SmartDev527/Temp_Con_CHB702/Photo/Screenshot 2025-01-17 143652.png

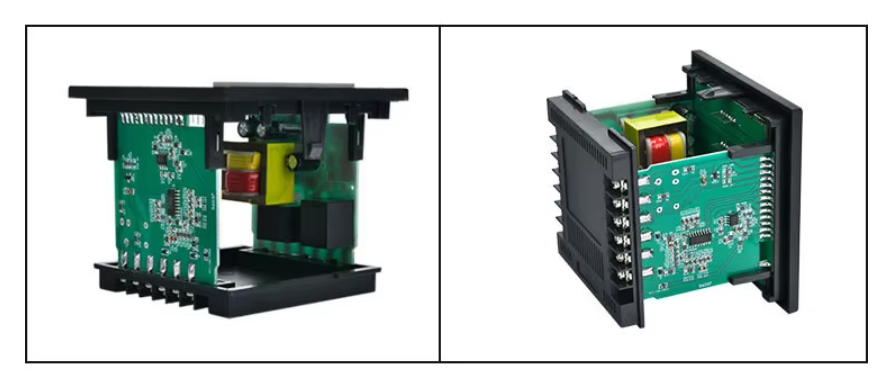
Photo/Screenshot 2025-01-17 143652.png
