SmartDev527/Temp_Con_CHB702/datasheets/7seg_multiplexing.png

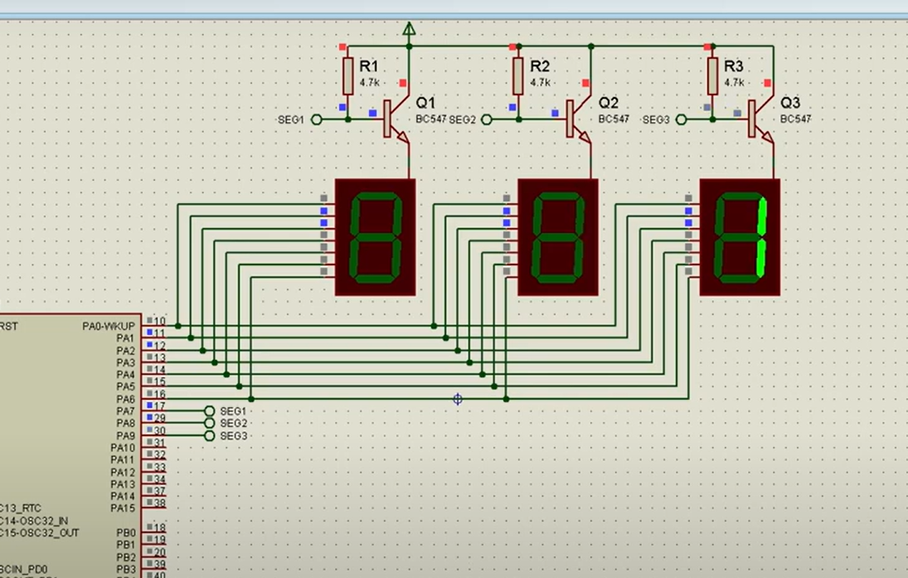
datasheets/7seg_multiplexing.png
