SmartDev527/Temp_Con_CHB702/datasheets/220VAC-12VDC.png

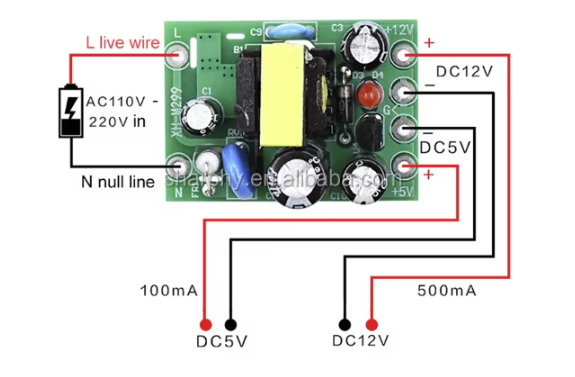
datasheets/220VAC-12VDC.png
