SmartDev527/Temp_Con_CHB702/datasheets/Application.png

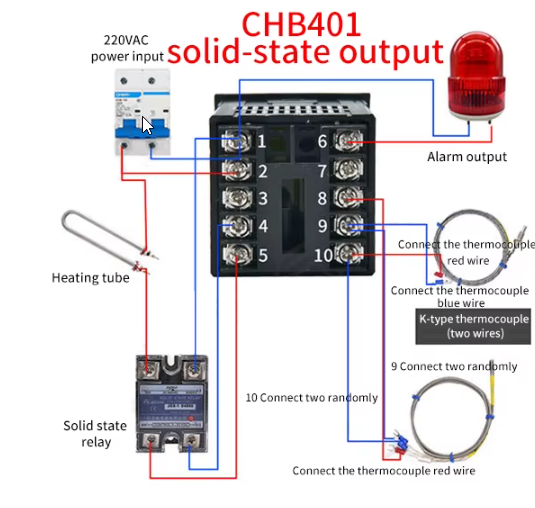
datasheets/Application.png
