SmartDev527/Temp_Con_CHB702/datasheets/JLPCB_Quote.png

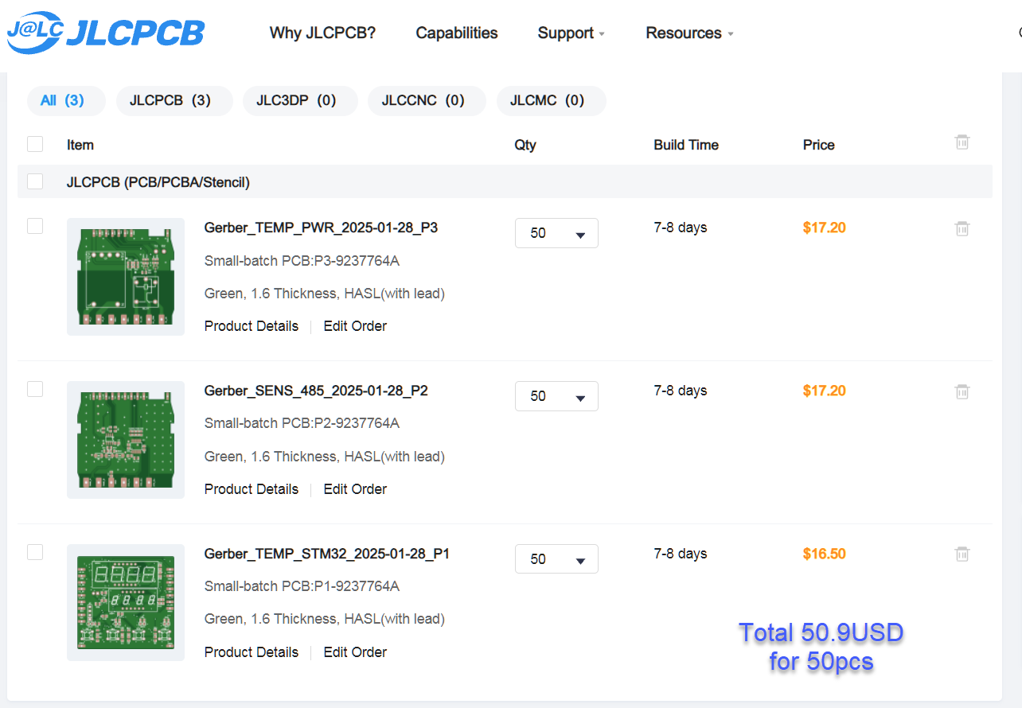
datasheets/JLPCB_Quote.png
