SmartDev527/Temp_Con_CHB702/datasheets/Terminal_Diagram.png

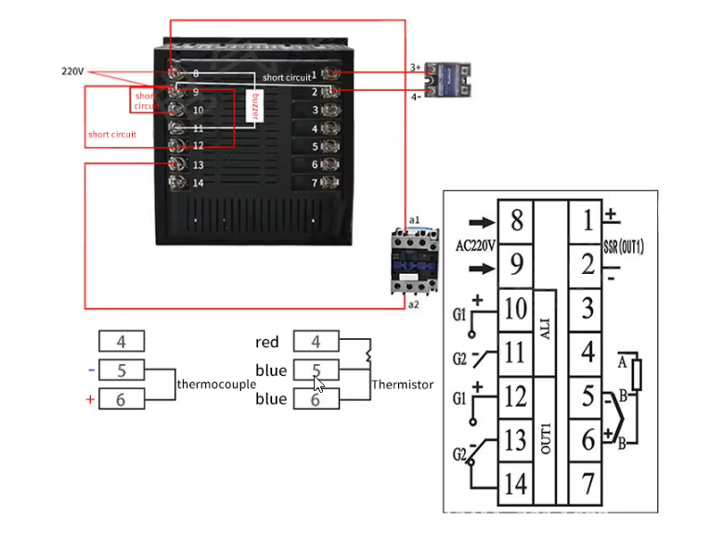
datasheets/Terminal_Diagram.png
