SmartDev527/Temp_Con_CHB702/Easy_EDA/PT100/Element_List/BOM_TEMP_PWR_TEMP_PWR_2025-01-28.xlsx

Comment | Designator | Footprint | Supplier Part | Value | Quantity | Supplier | Manufacturer | Manufacturer Part
AO3400A | Q3,Q20 | SOT-23-3_L2.9-W1.3-P1.90-LS2.4-BR | C347475 |  | 2 | LCSC | UMW(友台半导体) | AO3400A
10kΩ | R4,R33 | R0805 | C84376 | 10kΩ | 2 | LCSC | YAGEO(国巨) | RC0805FR-0710KL
1kΩ | R32,R34 | R0805 | C95781 | 1kΩ | 2 | LCSC | YAGEO(国巨) | RC0805FR-071KL
0Ω | R36,R37,R40 | R0805 | C96345 | 0Ω | 3 | LCSC | YAGEO(国巨) | RC0805JR-070RL
SRD-12VDC-SL-C | RELAY1 | RELAY-TH_SRD-XXVDC-XL-C | C30431 |  | 1 | LCSC | 松乐 | SRD-12VDC-SL-C
P_12V5V_MOD | U2 | P_MOD1 |  |  | 1 | https://www.alibaba.com/product-detail/Mini-AC-DC-Converter-AC-110V_1600088389790.html |  | 220VA to 12VDC converter
