SmartDev527/Temp_Con_CHB702/Easy_EDA/PT100/Element_List/BOM_TEMP_STM32_TEMP_STM32_2025-01-28.xlsx

Comment | Designator | Footprint | Supplier Part | Value | Quantity | Supplier | Manufacturer | Manufacturer Part
10uF | C1,C17 | C1210 | C2918502 | 10uF | 2 | LCSC | SAMWHA(三和) | CS3225X7R106K500NRL
22uF | C2,C18,C19,C40,C44 | C0805 | C907991 | 22uF | 5 | LCSC | muRata(村田) | GRM21BZ71A226ME15L
100nF | C3,C4,C5,C6,C16,C20,C22,C41,C45,C46 | C0805 | C49678 | 100nF | 10 | LCSC | YAGEO(国巨) | CC0805KRX7R9BB104
10uF | C23 | C0805 | C77075 | 10uF | 1 | LCSC | muRata(村田) | GRM21BR61C106KE15L
100pF | C38,C39,C42,C43,C47,C48,C49,C50,C51,C52 | C0805 | C107140 | 100pF | 10 | LCSC | YAGEO(国巨) | CC0805KRX7R9BB101
FJ4401BH | DISP0 | LED-SEG-TH_12P-L40.4-W16.0-P2.54-S12.70-BL | C10712 |  | 1 | LCSC | 志浩 | FJ4401BH
FJ3461BH | DISP1 | LED-SEG-TH_12P-L30.0-W13.7-P2.54-S10.16-BL | C10711 |  | 1 | LCSC | 志浩 | FJ3461BH
PZ254V-11-02P | H1 | HDR-TH_2P-P2.54-V-M | C492401 |  | 1 | LCSC | XFCN(兴飞) | PZ254V-11-02P
PZ254V-11-04P | H2 | HDR-TH_4P-P2.54-V-M | C2691448 |  | 1 | LCSC | XFCN(兴飞) | PZ254V-11-04P
3.3uH | L1 | IND-SMD_L5.4-W5.2_RS0530 | C32712971 | 3.3uH | 1 | LCSC | Ruishen(瑞申电子) | RS0530-3R3MS
XL-2012SURC | LED1,LED2,LED3,LED4 | LED0805-R-RD | C965812 |  | 4 | LCSC | XINGLIGHT(成兴光) | XL-2012SURC
56.2kΩ | R1 | R0805 | C483186 | 56.2kΩ | 1 | LCSC | YAGEO(国巨) | RC0805FR-0756K2L
10kΩ | R2,R22,R23,R24,R48,R84,R85,R86,R87,R88,R89 | R0805 | C84376 | 10kΩ | 11 | LCSC | YAGEO(国巨) | RC0805FR-0710KL
1kΩ | R32,R90,R91,R92 | R0805 | C95781 | 1kΩ | 4 | LCSC | YAGEO(国巨) | RC0805FR-071KL
YTS1R0011FBT00 | SW1,SW2,SW3,SW4 | SW-TH_4P-L6.0-W6.0-P4.50-LS6.5 | C5274850 |  | 4 | LCSC | YIYUAN(怡远) | YTS1R0011FBT00
TSC005A1618A03 | SW5 | KEY-SMD_4P-L5.2-W5.2-P3.70-LS6.4 | C2888970 |  | 1 | LCSC | BZCN(博众电气) | TSC005A1618A03
STM32F103RCT6 | U1 | LQFP-64_L10.0-W10.0-P0.50-LS12.0-BL | C8323 |  | 1 | LCSC | ST(意法半导体) | STM32F103RCT6
TPS562208DDCR | U5 | SOT-23-6_L2.9-W1.6-P0.95-LS2.8-BR | C91301 |  | 1 | LCSC | TI(德州仪器) | TPS562208DDCR
AMS1117-3.3 | U6 | SOT-223-3_L6.5-W3.4-P2.30-LS7.0-BR | C6068481 |  | 1 | LCSC | GOODWORK(固得沃克) | AMS1117-3.3
TM1637 | U11,U12 | SOP-20_L12.8-W7.5-P1.27-LS10.4-BL | C2962580 |  | 2 | LCSC | TM(天微) | TM1637
