SmartDev527/Temp_Con_CHB702/Easy_EDA/PT100/Element_List/BOM_TEMP_PT_485_PT_485_2025-01-28.xlsx

Comment | Designator | Footprint | Supplier Part | Value | Quantity | Supplier | Manufacturer | Manufacturer Part
100nF | C7,C8,C9,C10 | C0805 | C49678 | 100nF | 4 | LCSC | YAGEO(国巨) | CC0805KRX7R9BB104
1nF | C11 | C0805 | C303890 | 1nF | 1 | LCSC | Walsin(华新科) | 0805B102K102CT
SMAJ12CA | D1,D2,D3 | SMA_L4.4-W2.6-LS5.0-BI | C152122 |  | 3 | LCSC | BORN(伯恩半导体) | SMAJ12CA
1kΩ | R5,R27,R28 | R0805 | C95781 | 1kΩ | 3 | LCSC | YAGEO(国巨) | RC0805FR-071KL
4.7kΩ | R29,R31 | R0805 | C60816 | 4.7kΩ | 2 | LCSC | YAGEO(国巨) | RC0805FR-074K7L
120Ω | R30 | R0805 | C114245 | 120Ω | 1 | LCSC | YAGEO(国巨) | RC0805FR-07120RL
0Ω | R36,R37,R38,R39 | R0805 | C96345 | 0Ω | 4 | LCSC | YAGEO(国巨) | RC0805JR-070RL
400Ω | R40 | R0805 | C153298 | 400Ω | 1 | LCSC | EVER OHMS(天二科技) | TR0805B400RP0525Z
SP3485EN-L/TR | U2 | SOIC-8_L5.0-W4.0-P1.27-LS6.0-BL | C8963 |  | 1 | LCSC | MaxLinear(迈凌) | SP3485EN-L/TR
MAX31865AAP+T | U3 | SSOP-20_L7.2-W5.3-P0.65-LS7.8-BL | C779509 |  | 1 | LCSC | ADI(亚德诺)/MAXIM(美信) | MAX31865AAP+T
