SmartDev527/Temp_Con_CHB702/Easy_EDA/Thermocouple type/Element_List/BOM_TEMP_TC_485_TC_485_2025-01-28.xlsx

Comment | Designator | Footprint | Supplier Part | Value | Quantity | Supplier | Manufacturer | Manufacturer Part
100nF | C7,C15,C16,C17 | C0805 | C49678 | 100nF | 4 | LCSC | YAGEO(国巨) | CC0805KRX7R9BB104
1nF | C11 | C0805 | C303890 | 1nF | 1 | LCSC | Walsin(华新科) | 0805B102K102CT
10nF | C14,C18 | C0805 | C83170 | 10nF | 2 | LCSC | YAGEO(国巨) | CC0805KRX7R9BB103
SMAJ12CA | D1,D2,D3 | SMA_L4.4-W2.6-LS5.0-BI | C152122 |  | 3 | LCSC | BORN(伯恩半导体) | SMAJ12CA
1kΩ | R5,R27,R28 | R0805 | C95781 | 1kΩ | 3 | LCSC | YAGEO(国巨) | RC0805FR-071KL
4.7kΩ | R29,R31 | R0805 | C60816 | 4.7kΩ | 2 | LCSC | YAGEO(国巨) | RC0805FR-074K7L
120Ω | R30 | R0805 | C114245 | 120Ω | 1 | LCSC | YAGEO(国巨) | RC0805FR-07120RL
100Ω | R41,R42 | R0805 | C105577 | 100Ω | 2 | LCSC | YAGEO(国巨) | RC0805FR-07100RL
0Ω | R43,R44,R45,R46 | R0805 | C96345 | 0Ω | 4 | LCSC | YAGEO(国巨) | RC0805JR-070RL
MAX31856MUD+T | U1 | TSSOP-14_L5.0-W4.4-P0.65-LS6.4-BL | C2653162 |  | 1 | LCSC | ADI(亚德诺)/MAXIM(美信) | MAX31856MUD+T
SP3485EN-L/TR | U2 | SOIC-8_L5.0-W4.0-P1.27-LS6.0-BL | C8963 |  | 1 | LCSC | MaxLinear(迈凌) | SP3485EN-L/TR
