SmartDev527/Temp_Con_CHB702/(list of files, drawings)

Other design files:
Easy_EDA/Temp_Con_V116.eprj
