SmartDev527/Temp_Con_CHB702/Firmware/Temp_Con.ioc

Mcu.UserName=STM32F103RCTx
PA13.Signal=SYS_JTMS-SWDIO
PA14.Signal=SYS_JTCK-SWCLK
PA15.Signal=SPI1_NSS
PA7.GPIO_Label=DIO1
PA7.Signal=GPIO_Output
PA8.GPIO_Label=SW1
PA8.Signal=GPXTI8
PB10.Signal=USART3_TX
PB11.Signal=USART3_RX
PB12.GPIO_Label=SW3
PB12.Signal=GPXTI12
PB13.GPIO_Label=SW2
PB13.Signal=GPXTI13
PB14.GPIO_Label=DIO2
PB14.Signal=GPIO_Output
PB15.GPIO_Label=SLK2
PB15.Signal=GPIO_Output
PB3.Signal=SPI1_SCK
PB4.Signal=SPI1_MISO
PB5.Signal=SPI1_MOSI
PB6.Signal=USART1_TX
PB7.Signal=USART1_RX
PC4.GPIO_Label=CLK1
PC4.Signal=GPIO_Output
PC6.GPIO_Label=LD4
PC6.Signal=GPIO_Output
PC7.GPIO_Label=LD3
PC7.Signal=GPIO_Output
PC8.GPIO_Label=LD2
PC8.Signal=GPIO_Output
PC9.GPIO_Label=LD1
PC9.Signal=GPIO_Output
