SmartDev527/Temp_Con_CHB702/(commit log)

2025-01-20 Initial files upload
    sketch 70% finished
    [Temp_Con_V116.eprj]
2025-02-10 final files uploaded
    [BOM_TEMP_PT_485_PT_485_2025-01-28.xlsx, BOM_TEMP_PWR_TEMP_PWR_2025-01-28.xlsx, BOM_TEMP_STM32_TEMP_STM32_2025-01-28.xlsx, BOM_TEMP_TC_485_TC_485_2025-01-28.xlsx, PickAndPlace_PT_485_2025-01-28.xlsx, PickAndPlace_TC_485_2025-01-28.xlsx, PickAndPlace_TEMP_PWR_2025-01-28.xlsx, PickAndPlace_TEMP_STM32_2025-01-28.xlsx]
2025-04-11 PID library upload
2025-05-19 Upload updates
    [BOM_TEMP_PT_485_PT_485_2025-01-28.xlsx, BOM_TEMP_PWR_TEMP_PWR_2025-01-28.xlsx, BOM_TEMP_STM32_TEMP_STM32_2025-01-28.xlsx, BOM_TEMP_TC_485_TC_485_2025-01-28.xlsx, PickAndPlace_PT_485_2025-01-28.xlsx, PickAndPlace_TC_485_2025-01-28.xlsx, PickAndPlace_TEMP_PWR_2025-01-28.xlsx, PickAndPlace_TEMP_STM32_2025-01-28.xlsx]
